JamesThorpe/LEDCube/(list of files, drawings)

Other design files:
docs/Cube Driver.pcb
docs/Cube Sink.pcb
