JamesThorpe/LEDCube/ledcube2/AnimationsFromOn.cpp

#include "animations.h"

void anim_OnToCornerDiagonal() {
	CubeCorners c = (CubeCorners)random(8);
	CubeCorners target = getOppositeCornerCube(c);
	anim_generalEnumerateAxis(c, target, false, false);
	cube->ActiveCorner = target;
	cube->State = State_corner;
}

void anim_OnToPlaneSimple() {
	Planes p = (Planes)random(6);
	anim_PlaneMove(p, false, false, true);
	cube->State = State_plane;
	cube->ActivePlane = getOppositePlane(p);
}
